HTLD-2024-4cWI-SPL-G2-STH/2024-4cWI-SPL-G2-STH-TeamB/README.md

# 2024-4cWI-SPL-G2-STH-TeamB
PV Module Frame Construction
