HTLD-2024-4cWI-SPL-G2-STH/2024-4cWI-SPL-G2-STH-TeamB/CAD_Design_Final.step

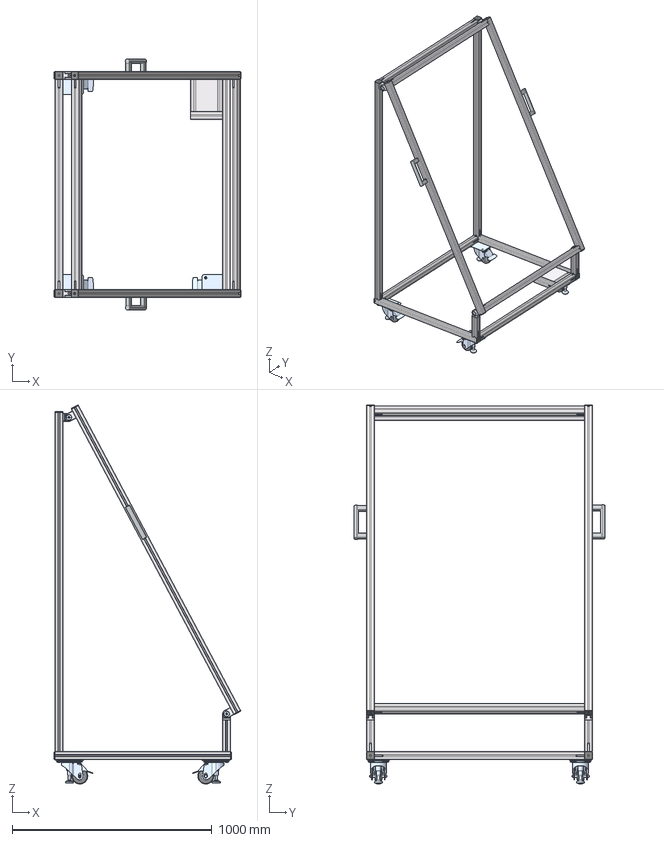
[picture p1: CAD file, 2025-06-10]
CAD_Design_Final.step
934.9 x 1258.7 x 1899.0 mm
item_0064764_Zylinderschraube DIN 912 M8x16_3
item_0064764_Zylinderschraube DIN 912 M8x16_2
item_0048048_Nutenstein V 8 St M8_7
item_0048048_Nutenstein V 8 St M8_5
item_0049486_Handgriff X 160 PA_3
item_0064764_Zylinderschraube DIN 912 M8x16_1
item_0064764_Zylinderschraube DIN 912 M8x16
item_0048048_Nutenstein V 8 St M8_3
item_0048048_Nutenstein V 8 St M8_1
item_0049486_Handgriff X 160 PA_1
item_0061631_Automatik-Verbindungssatz 8 Abdeckblende_65
item_0038808_Automatik-Verbindungssatz 8_65
item_0061631_Automatik-Verbindungssatz 8 Abdeckblende_63
item_0038808_Automatik-Verbindungssatz 8_63
item_0002618_Nutenstein 8 St M8_11
item_0049411_Schwenklager 8 40x40_W=62_11
item_0049411_Schwenklager 8 40x40_W=62_10
item_0049411_Schwenklager 8 40x40_W=62_9
item_0049411_Schwenklager 8 40x40_W=62_8
item_0002618_Nutenstein 8 St M8_9
item_0049411_Schwenklager 8 40x40_W=62_5
item_0049411_Schwenklager 8 40x40_W=62_4
item_0049411_Schwenklager 8 40x40_W=62_3
item_0049411_Schwenklager 8 40x40_W=62_2
item_0062690_Abdeckkappe 8 40x40, gummiert_9
item_0062690_Abdeckkappe 8 40x40, gummiert_8
item_0062690_Abdeckkappe 8 40x40, gummiert_7
item_0062690_Abdeckkappe 8 40x40, gummiert_6
item_0002618_Nutenstein 8 St M8_7
item_0002618_Nutenstein 8 St M8_5
item_0049411_Schwenklager 8 40x40_W=-28_11
item_0049411_Schwenklager 8 40x40_W=-28_10
item_0049411_Schwenklager 8 40x40_W=-28_9
item_0049411_Schwenklager 8 40x40_W=-28_8
item_0061631_Automatik-Verbindungssatz 8 Abdeckblende_61
item_0038808_Automatik-Verbindungssatz 8_61
item_0061631_Automatik-Verbindungssatz 8 Abdeckblende_59
item_0038808_Automatik-Verbindungssatz 8_59
item_0061631_Automatik-Verbindungssatz 8 Abdeckblende_57
item_0038808_Automatik-Verbindungssatz 8_57
item_0061631_Automatik-Verbindungssatz 8 Abdeckblende_55
item_0038808_Automatik-Verbindungssatz 8_55
item_0061631_Automatik-Verbindungssatz 8 Abdeckblende_53
item_0038808_Automatik-Verbindungssatz 8_53
item_0061631_Automatik-Verbindungssatz 8 Abdeckblende_51
item_0038808_Automatik-Verbindungssatz 8_51
item_0061631_Automatik-Verbindungssatz 8 Abdeckblende_49
item_0038808_Automatik-Verbindungssatz 8_49
item_0061631_Automatik-Verbindungssatz 8 Abdeckblende_47
item_0038808_Automatik-Verbindungssatz 8_47
item_0002603_Profil 8 40x40_L=1052.5_4
item_0002603_Profil 8 40x40_L=1052.5_3
item_0002603_Profil 8 40x40_L=1730_1
item_0002603_Profil 8 40x40_L=1730
item_0002618_Nutenstein 8 St M8_3
item_0002618_Nutenstein 8 St M8_1
item_0049411_Schwenklager 8 40x40_W=-28_5
item_0049411_Schwenklager 8 40x40_W=-28_4
item_0049411_Schwenklager 8 40x40_W=-28_3
item_0049411_Schwenklager 8 40x40_W=-28_2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
