HTLD-2024-4cWI-SPL-G2-STH/2024-4cWI-SPL-G2-STH-TeamB/(threads)

Thread 8 (2024-11-12):

Initial planning and Measuring

Raphael-Maringer, 2024-11-12:
As a team of developers, we want to measure the dimensions of the PV panel and discuss how we will implement the key functionalities (e.g. adjustable incline, mobility) so that we can design a frame that meets all requirements.

Acceptance Criteria:

- Correct measurements of the PV panel
- Key functionalities identified and written down

Closed 2024-11-12.

Thread 12 (2024-11-26):

Adjustable Panel Mount

scalarion, 2024-11-26:
As a user I want to be able to adjust the angle of the PV panel so that I can optimize energy production.

Acceptance Criteria:
- Panel angle adjustment mechanism allows setting between 0-45°
- Panel produces >95% of max rated power when set to 30° angle at solar noon
- Adjustment can be completed in <2 minutes without special tools
- Locking mechanism withstands 750N vertical load test for 24h without movement
- Frame stability test: <1cm deviation from vertical when pushed with 300N horizontal force at max height
- All tests and protocols documented in the project Wiki

Thread 13 (2024-11-26):

Mobile Frame with Coasters

scalarion, 2024-11-26:
As a user I want the frame to have coasters so that I can move it around freely.

Acceptance Criteria:
- Frame equipped with 4x industrial-grade 360° coasters rated for min. 25kg each
- Each coaster has individual braking mechanism that holds against 200N horizontal force
- Frame maintains vertical position within ±2° when moved on flat surface
- Maximum rolling resistance of 150N force required to initiate movement
- Coasters rated IP65 for water/dust protection
- Frame stability test: <1cm deviation from vertical when pushed with 300N horizontal force at max height
- All tests and protocols documented in the project Wiki
