HTLD-2024-4cWI-SPL-G2-STH/2024-4cWI-SPL-G2-STH-TeamB/Frame_full-documentation.pdf

## Projektübersicht

### Projektname: Neuer PV Modul Rahmen, fertig

### Projektnummer: 0f5f4bc1ac574d02a5001c80fd883be35

### Projektbeschreibung: endlich, der schmerz

i24.ws/6Jj3yt1W

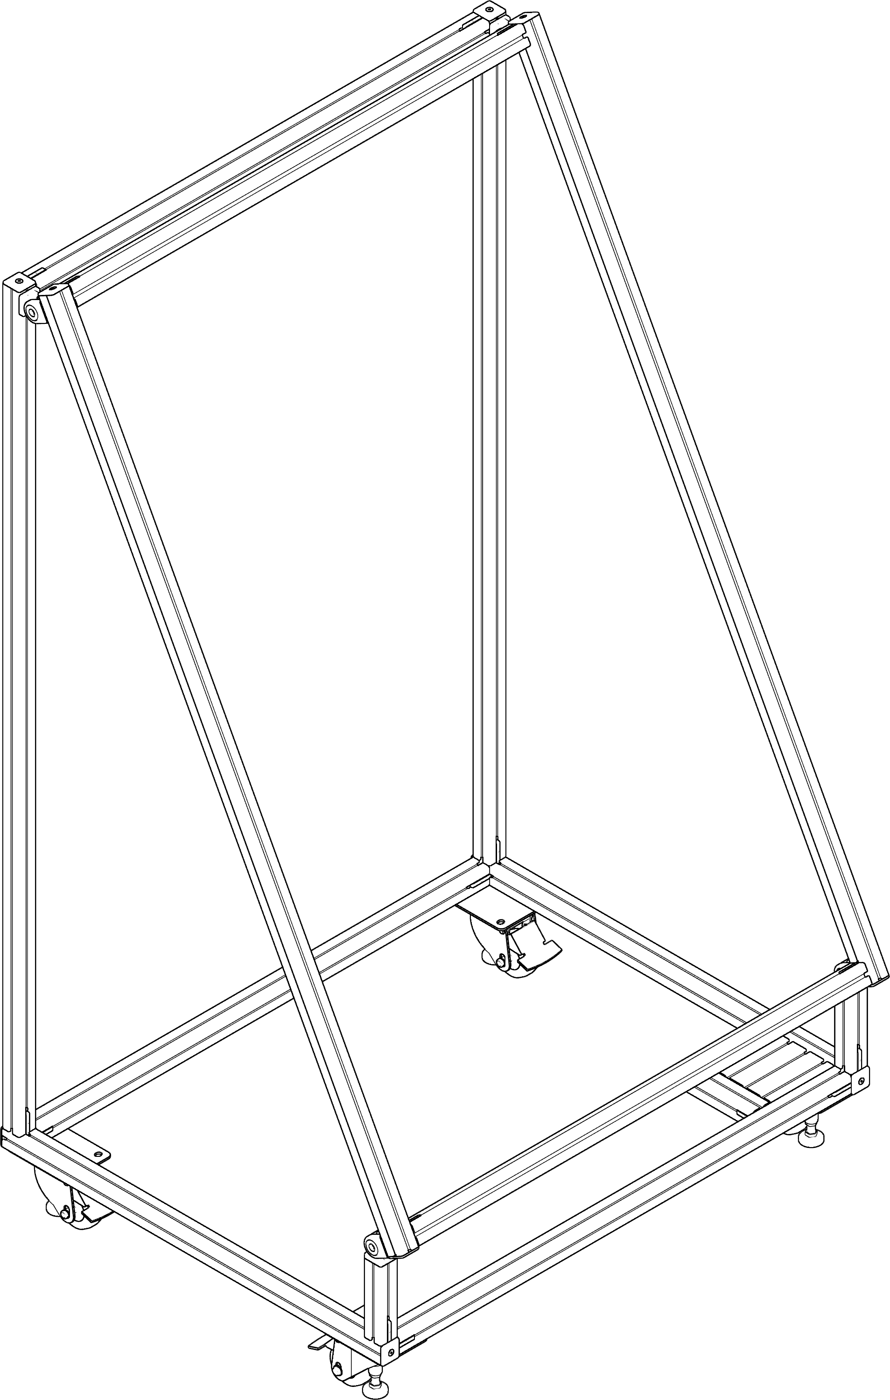
[picture p2: figure]

Seite 1 / 15 Projekt: Neuer PV Modul Rahmen, fertig, 0f5f4bc1ac574d02a5001c80fd883be35

# Baugruppenübersicht

## Projektübersicht | Baugruppenübersicht | Lieferstückliste | Stückliste | Unbearbeitete Profile | Profilbearbeitungen |

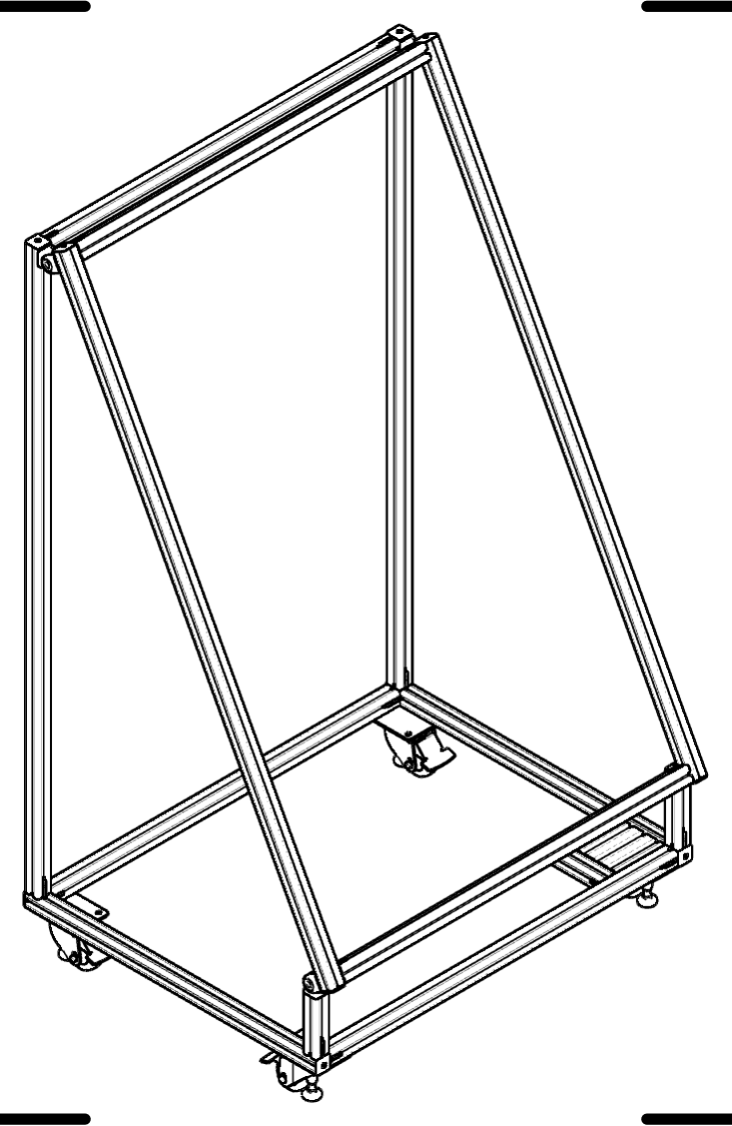
[picture p3: figure]

## Baugruppe 1

## Isometrische Ansicht | Dreitafelprojektion | Explosionsdarstellung | Montageanleitung |

Seite 2 / 15 Projekt: Neuer PV Modul Rahmen, fertig, 0f5f4bc1ac574d02a5001c80fd883be35

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
## Lieferstückliste

Anzahl | Artikelbezeichnung | Artikel-Nr. | Position
1 | Profil 8 40x40 leicht, natur Länge: 160mm | 0.0.026.33 | 1
2 | Profil 8 40x40 leicht, natur Länge: 880mm | 0.0.026.33 | 2
5 | Profil 8 40x40 leicht, natur Länge: 1052.5mm | 0.0.026.33 | 3
1 | Profil 8 40x40 leicht, natur Länge: 1700mm | 0.0.026.33 | 4
2 | Profil 8 40x40 leicht, natur Länge: 1730mm | 0.0.026.33 | 5
1 | Profil 8 160x40 leicht, natur Länge: 147mm | 0.0.418.35 | 6
1 | Profil 8 40x40 E, natur Länge: 1700mm | 7.0.000.09 | 7
2 | Profil 8 40x40 leicht, natur Länge: 159.23mm | 0.0.026.33 | 8v
33 | Automatik-Verbindungssatz 8 Abdeckblende, grau ähnlich RAL 7042 | 0.0.616.31 | 9
10 | Abdeckkappe 8 40x40, gummiert | 0.0.626.90 | 10
4 | Heberolle D80 140x110 mit Fußpedal ESD | 0.0.684.37 | 11
5 | Nutenstein 8 St M8, verzinkt | 0.0.026.18 | 12
33 | Automatik-Verbindungssatz 8, verzinkt | 0.0.388.08 | 13
4 | Schwenklager 8 40x40 | 0.0.494.11 | 14
12 | Befestigungssatz 8 für Lenk-/Bockrolle 140x110 | 0.0.670.18 | 15

Seite 3 / 15 Projekt: Neuer PV Modul Rahmen, fertig, 0f5f4bc1ac574d02a5001c80fd883be35

## Stückliste

Position | Artikelbezeichnung | Artikel-Nr. | Seite | Anzahl
1 | Profil 8 40x40 leicht, natur, Länge: 160mm | 0.0.026.33 | 5 | 1
2 | Profil 8 40x40 leicht, natur, Länge: 880mm | 0.0.026.33 | 5 | 2
3 | Profil 8 40x40 leicht, natur, Länge: 1052.5mm | 0.0.026.33 | 5 | 5
4 | Profil 8 40x40 leicht, natur, Länge: 1700mm | 0.0.026.33 | 5 | 1
5 | Profil 8 40x40 leicht, natur, Länge: 1730mm | 0.0.026.33 | 5 | 2
6 | Profil 8 160x40 leicht, natur, Länge: 147mm | 0.0.418.35 | 5 | 1
7 | Profil 8 40x40 E, natur, Länge: 1700mm | 7.0.000.09 | 6 | 1
8v | Profil 8 40x40 leicht, natur, Länge: 159.23mm | 0.0.026.33 | 7 | 2
9 | Automatik-Verbindungssatz 8 Abdeckblende, grau ähnlich RAL 7042 | 0.0.616.31 | - | 33
10 | Abdeckkappe 8 40x40, gummiert | 0.0.626.90 | - | 10
11 | Heberolle D80 140x110 mit Fußpedal ESD | 0.0.684.37 | - | 4
12 | Nutenstein 8 St M8, verzinkt | 0.0.026.18 | - | 5
13 | Automatik-Verbindungssatz 8, verzinkt | 0.0.388.08 | - | 33
14 | Schwenklager 8 40x40 | 0.0.494.11 | - | 4
15 | Befestigungssatz 8 für Lenk-/Bockrolle 140x110 | 0.0.670.18 | - | 12

## Verbindungstechnik ( gesamt )

5x

0.0.026.18

33x

0.0.388.08

4x

0.0.494.11

12x

0.0.670.18

Seite 4 / 15 Projekt: Neuer PV Modul Rahmen, fertig, 0f5f4bc1ac574d02a5001c80fd883be35

## Unbearbeitete Profile

## Teil 1, Profil 8 40x40 leicht, natur

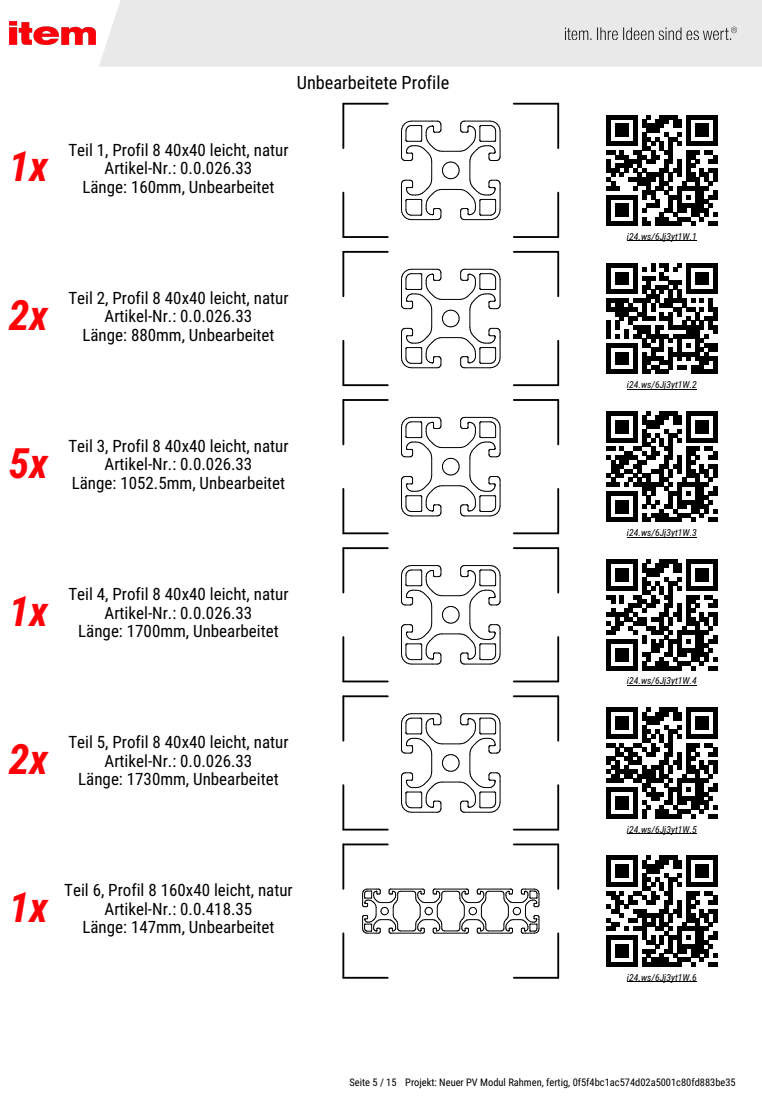
[picture p4: page 5]
Projekt : unnamed; Artikel-Nr.: 0.0.026.33; Länge: 160mm, Unbearbeitet 1x; Länge: 880mm, Unbearbeitet 2x; Länge: 1052.5mm, Unbearbeitet 5x; Länge: 1700mm, Unbearbeitet 1x; Länge: 1730mm, Unbearbeitet 2x; Artikel-Nr.: 0.0.418.35

Teil 2, Profil 8 40x40 leicht, natur
Artikel-Nr.: 0.0.026.33

Teil 3, Profil 8 40x40 leicht, natur

Teil 4, Profil 8 40x40 leicht, natur

Teil 5, Profil 8 40x40 leicht, natur

Teil 6, Profil 8 160x40 leicht, natur
Länge: 147mm, Unbearbeitet 1x

Seite 5 / 15 Projekt: Neuer PV Modul Rahmen, fertig, 0f5f4bc1ac574d02a5001c80fd883be35

## Unbearbeitete Profile

## Teil 7, Profil 8 40x40 E, natur

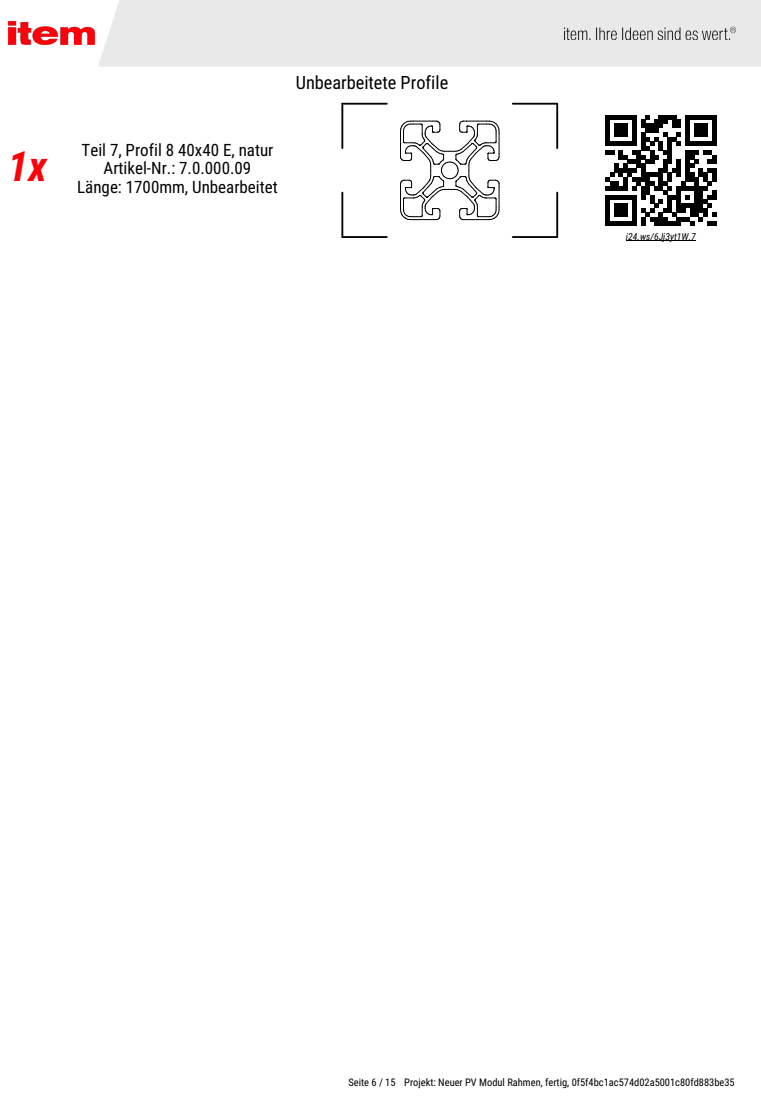
[picture p5: page 6]
Artikel-Nr.: 7.0.000.09; Länge: 1700mm, Unbearbeitet 1x

Seite 6 / 15 Projekt: Neuer PV Modul Rahmen, fertig, 0f5f4bc1ac574d02a5001c80fd883be35

Bearbeitungen Teil 8v, Profil 8 40x40 leicht, natur 2x | Artikel-Nr.: 0.0.026.33, Länge: 159.23mm

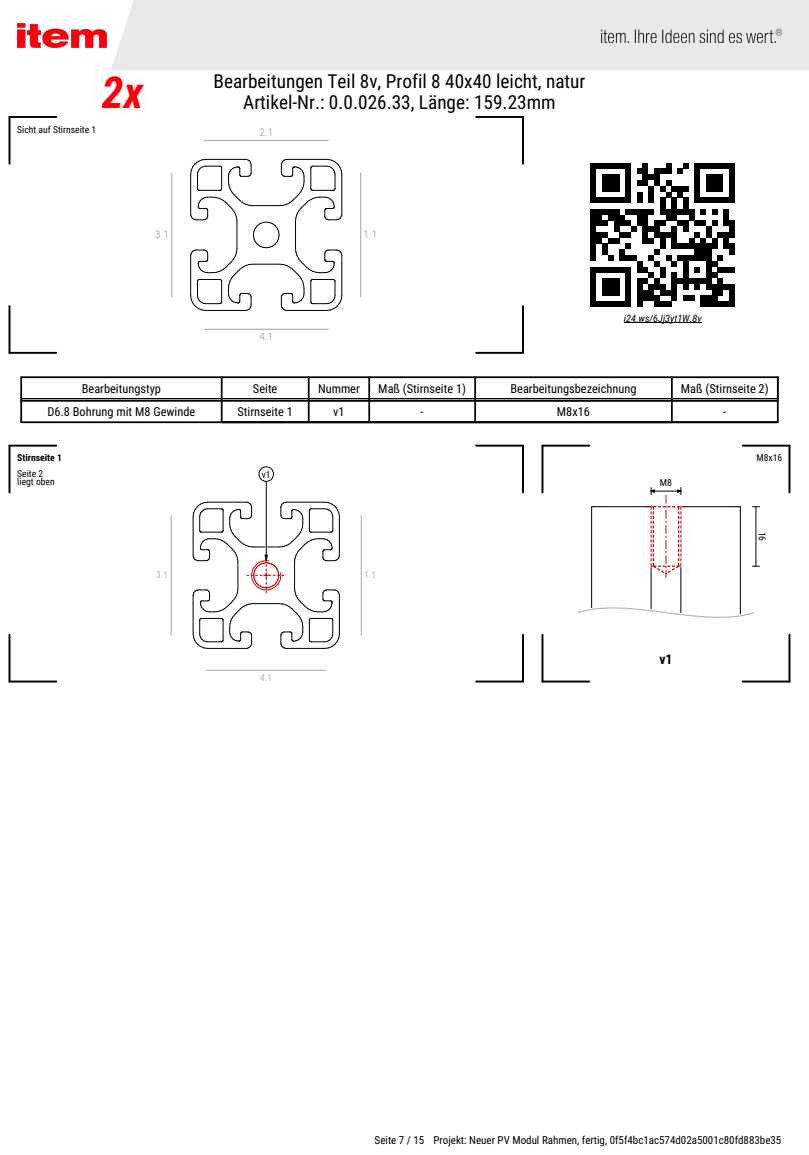
[picture p6: page 7]
Stirnseite 1; Seite 2; v1 liegt oben

Sicht auf Stirnseite 1

Bearbeitungstyp | Seite | Nummer | Maß (Stirnseite 1) | Bearbeitungsbezeichnung | Maß (Stirnseite 2)
D6.8 Bohrung mit M8 Gewinde | Stirnseite 1 | v1 | - | M8x16 | -

Seite 7 / 15 Projekt: Neuer PV Modul Rahmen, fertig, 0f5f4bc1ac574d02a5001c80fd883be35

## Kontrollansicht (Bearbeitungen) Teil 8v

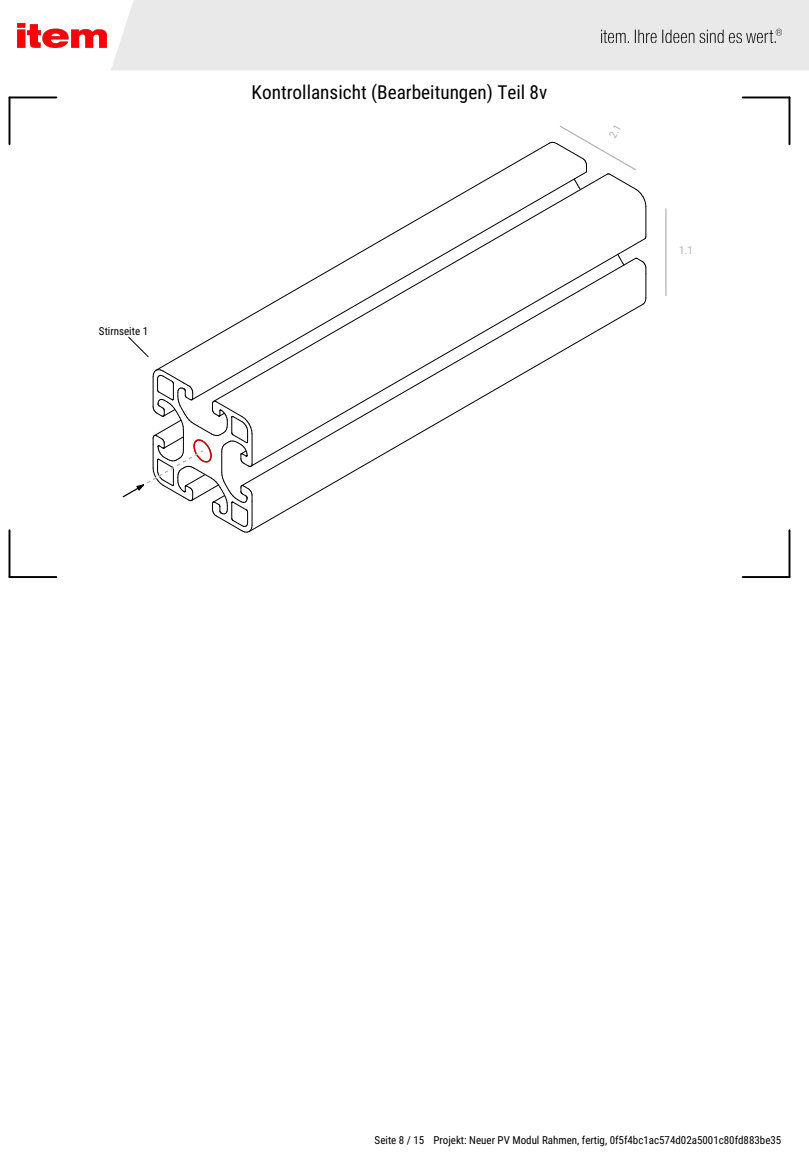
[picture p7: page 8]
Stirnseite 1

Seite 8 / 15 Projekt: Neuer PV Modul Rahmen, fertig, 0f5f4bc1ac574d02a5001c80fd883be35

## Isometrische Ansicht Baugruppe 1 / 1

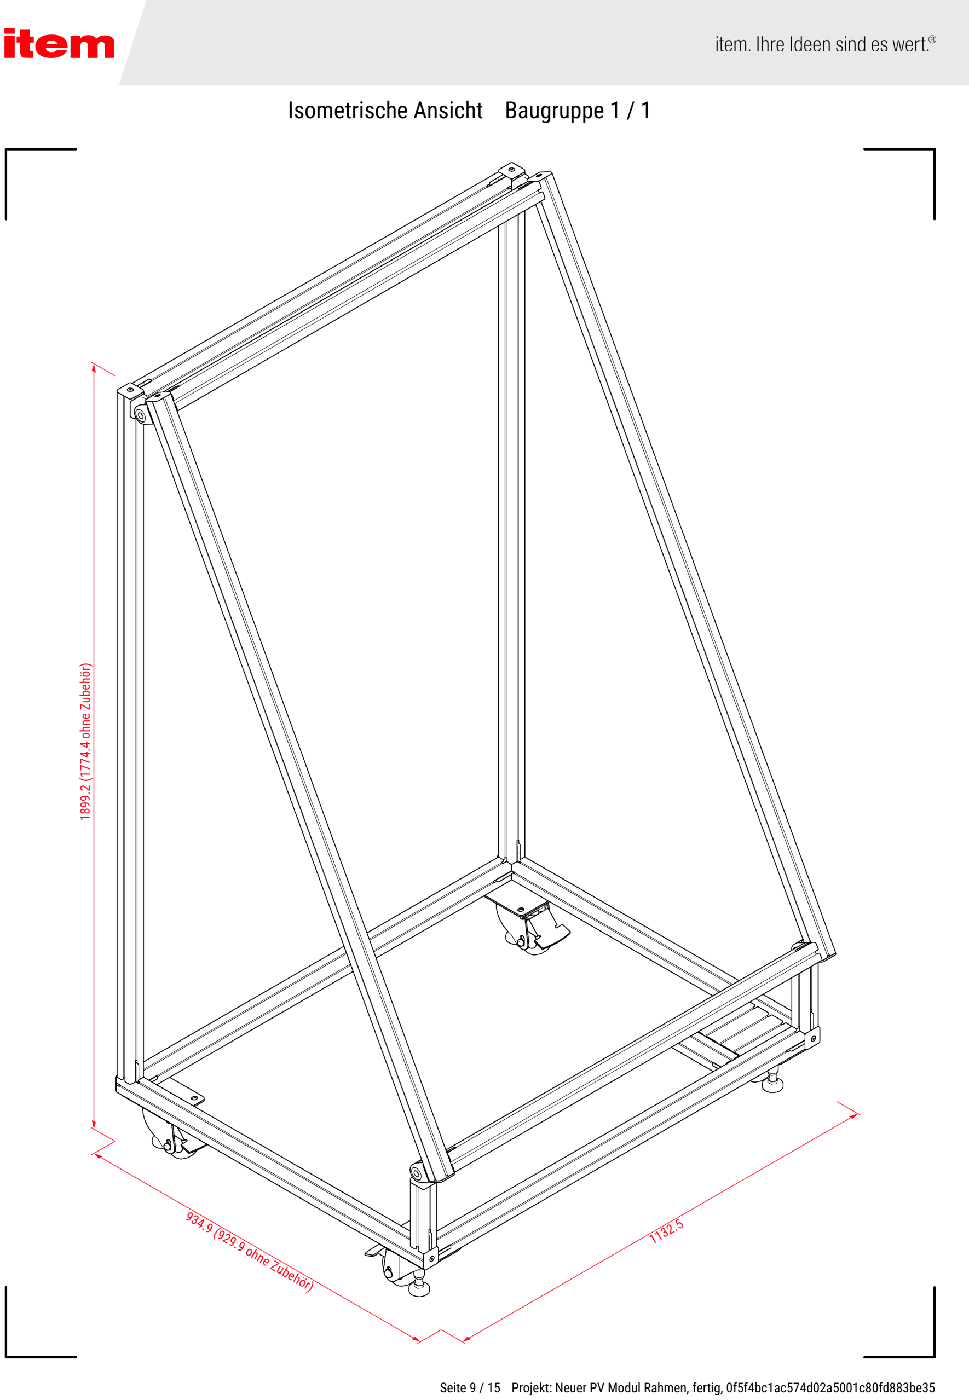
[picture p8: page 9]

Seite 9 / 15 Projekt: Neuer PV Modul Rahmen, fertig, 0f5f4bc1ac574d02a5001c80fd883be35

## Dreitafelprojektion Baugruppe 1 / 1

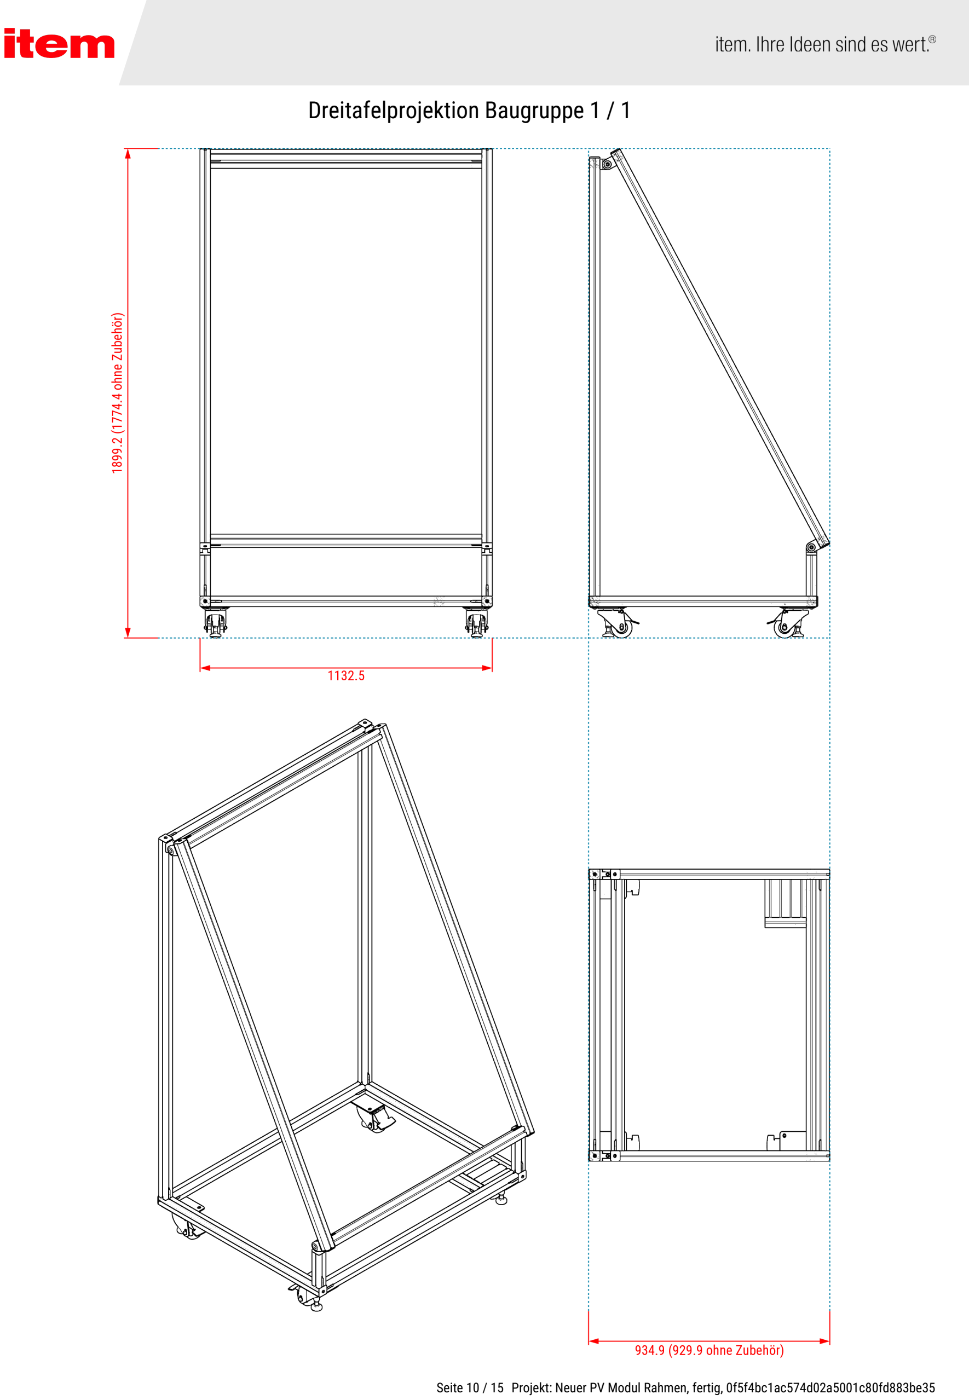
[picture p9: page 10]

Seite 10 / 15 Projekt: Neuer PV Modul Rahmen, fertig, 0f5f4bc1ac574d02a5001c80fd883be35

## Explosionsdarstellung Baugruppe 1 / 1

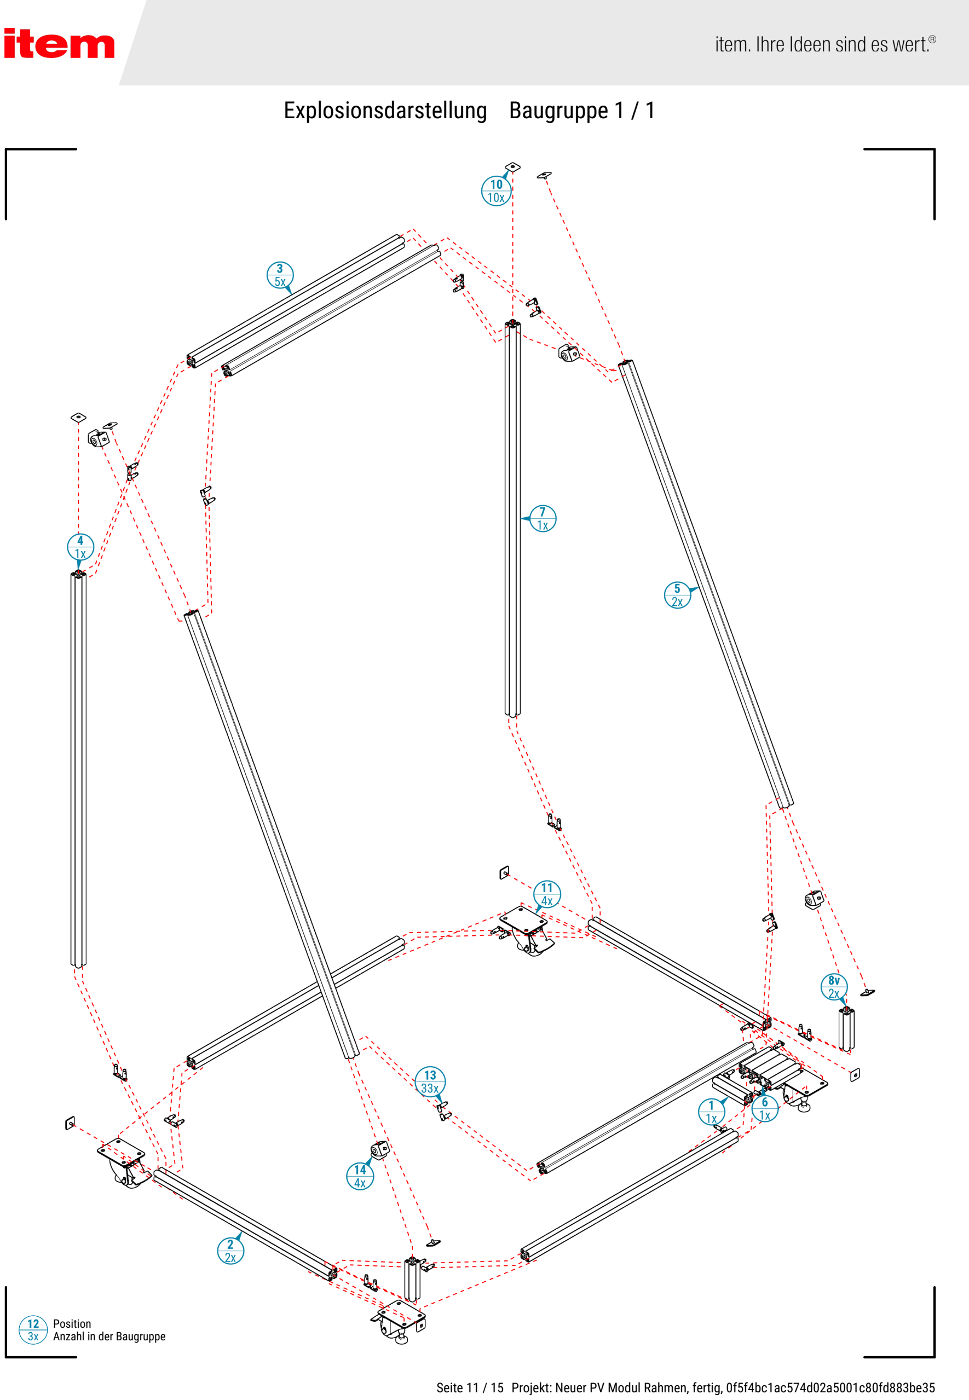
[picture p10: page 11]

### 12 Position

3x Anzahl in der Baugruppe

Seite 11 / 15 Projekt: Neuer PV Modul Rahmen, fertig, 0f5f4bc1ac574d02a5001c80fd883be35

## Montageanleitung

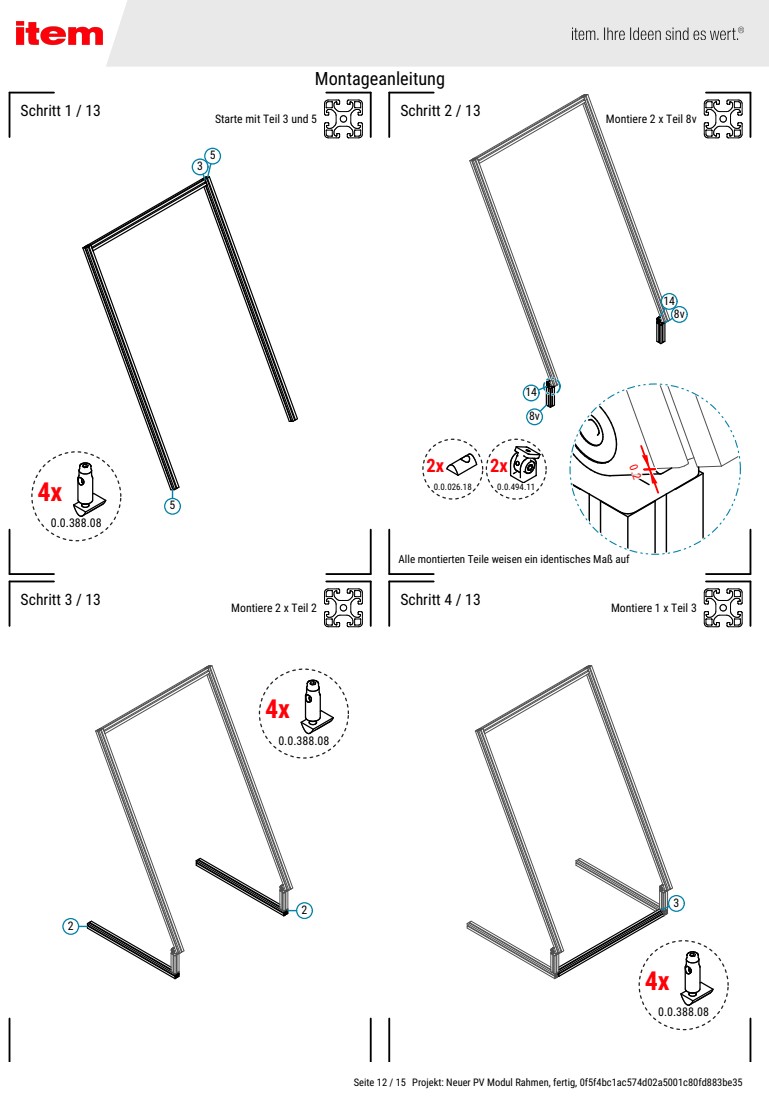
[picture p11: page 12]

Starte mit Teil 3 und 5 Schritt 1 / 13

Montiere 2 x Teil 8v Schritt 2 / 13

Alle montierten Teile weisen ein identisches Maß auf

Montiere 2 x Teil 2 Schritt 3 / 13

Montiere 1 x Teil 3 Schritt 4 / 13

Seite 12 / 15 Projekt: Neuer PV Modul Rahmen, fertig, 0f5f4bc1ac574d02a5001c80fd883be35

## Montageanleitung

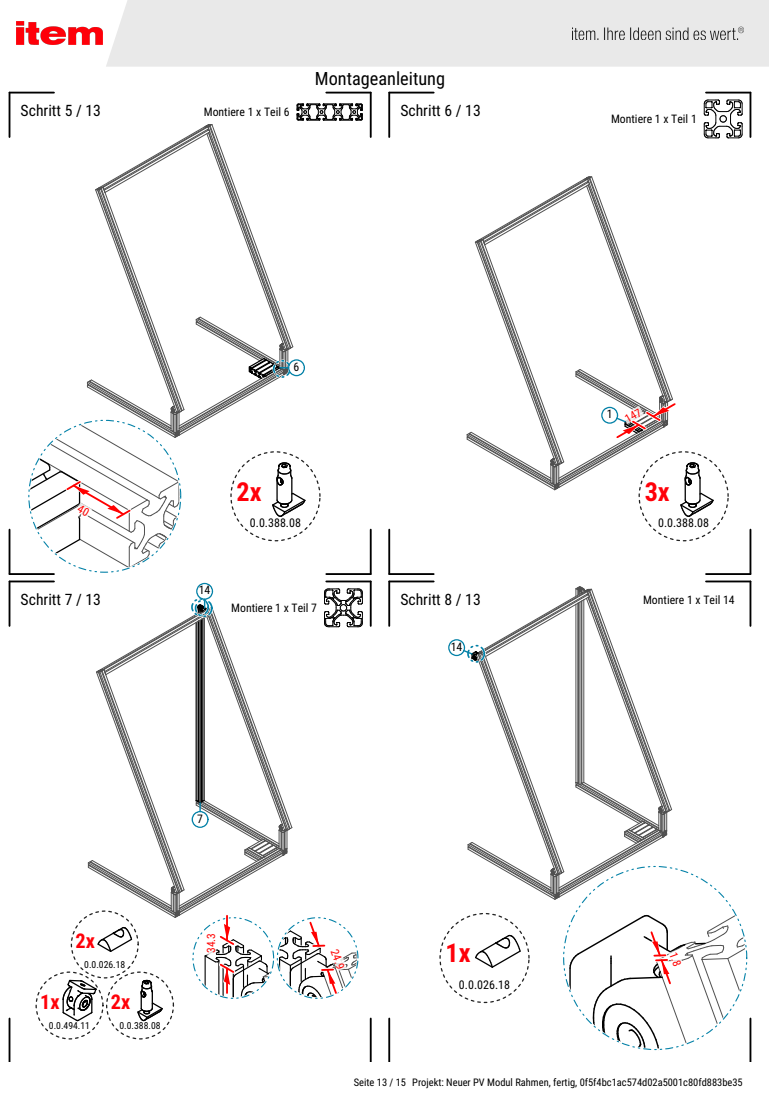
[picture p12: page 13]
Schritt 5 / 13; Montiere 1 x Teil 6; Schritt 8 / 13; Montiere 1 x Teil 14

Montiere 1 x Teil 1 Schritt 6 / 13

Montiere 1 x Teil 7 Schritt 7 / 13

Seite 13 / 15 Projekt: Neuer PV Modul Rahmen, fertig, 0f5f4bc1ac574d02a5001c80fd883be35

## Montageanleitung

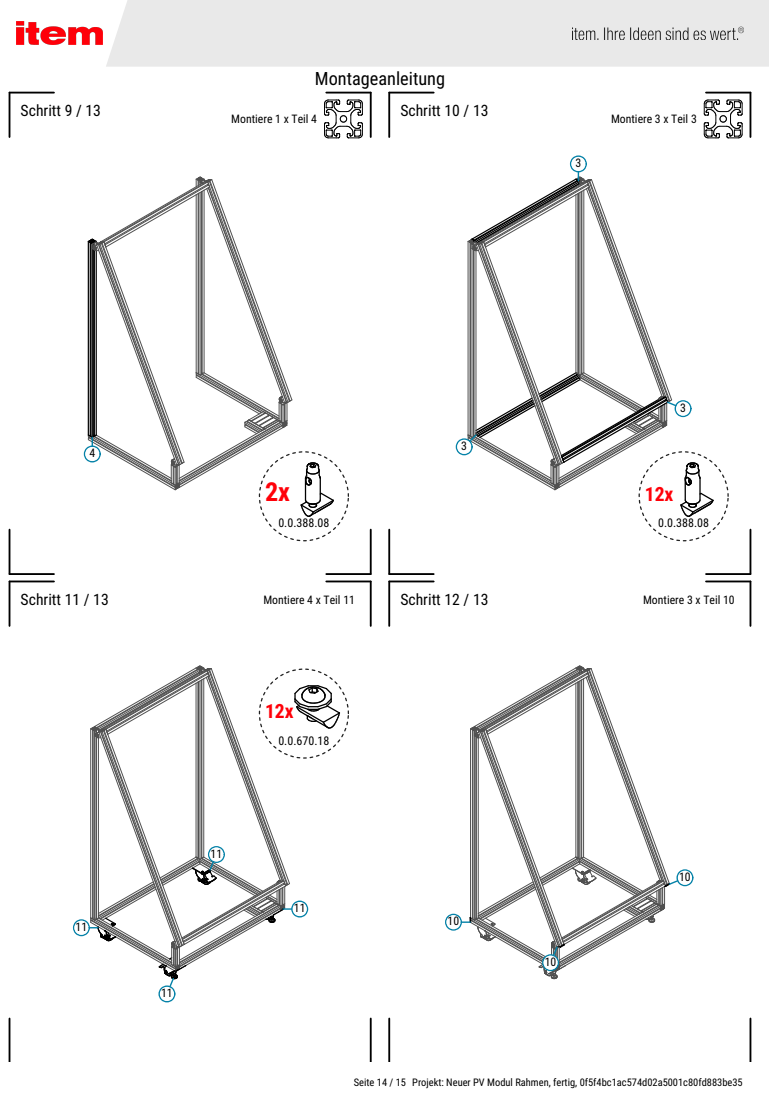
[picture p13: page 14]
Schritt 11 / 13; Montiere 4 x Teil 11; Schritt 12 / 13; Montiere 3 x Teil 10

Montiere 1 x Teil 4 Schritt 9 / 13

Montiere 3 x Teil 3 Schritt 10 / 13

Seite 14 / 15 Projekt: Neuer PV Modul Rahmen, fertig, 0f5f4bc1ac574d02a5001c80fd883be35

## Montageanleitung

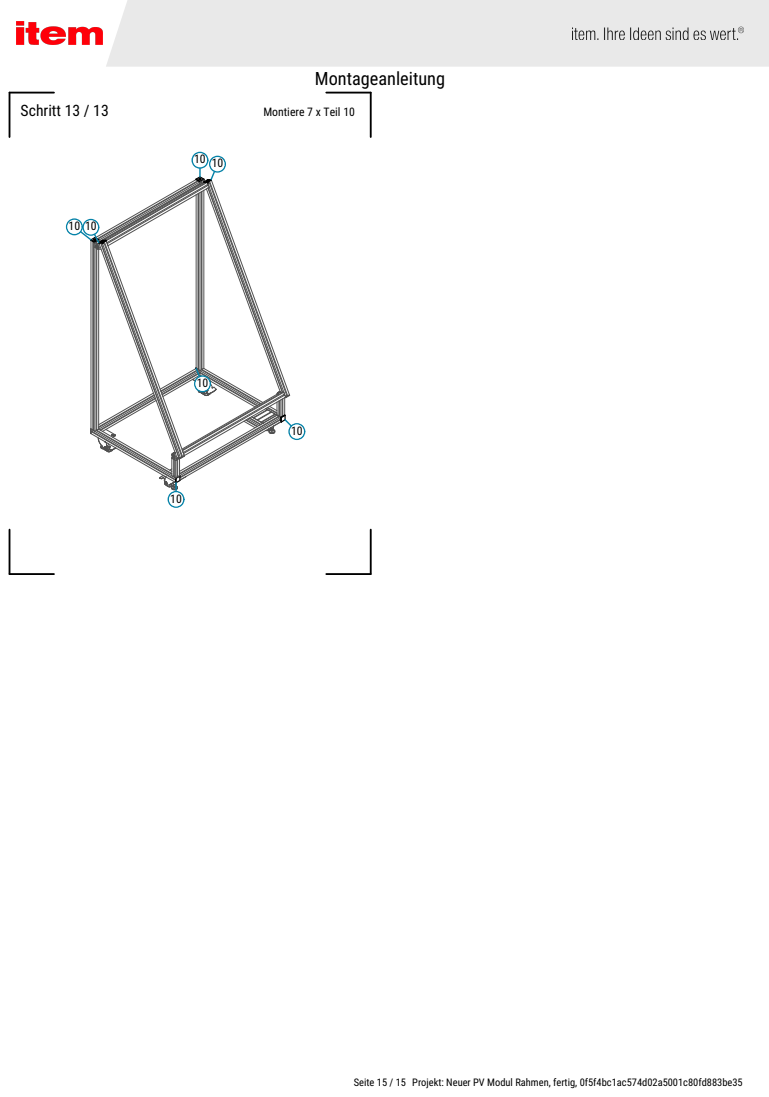
[picture p14: page 15]
Schritt 13 / 13; Montiere 7 x Teil 10

Seite 15 / 15 Projekt: Neuer PV Modul Rahmen, fertig, 0f5f4bc1ac574d02a5001c80fd883be35
