HTLD-2024-4cWI-SPL-G2-STH/2024-4cWI-SPL-G2-STH-TeamB/full_doc_en-AT_020fce40189548b49f6569aafb30beff14_abcdeimrstvxz.pdf

## Project overview

### Project name: N1 PV Halter

### Project number: 020fce40189548b49f6569aafb30beff14

### Project description: Nummer 1

i24.ws/nNwMweX7

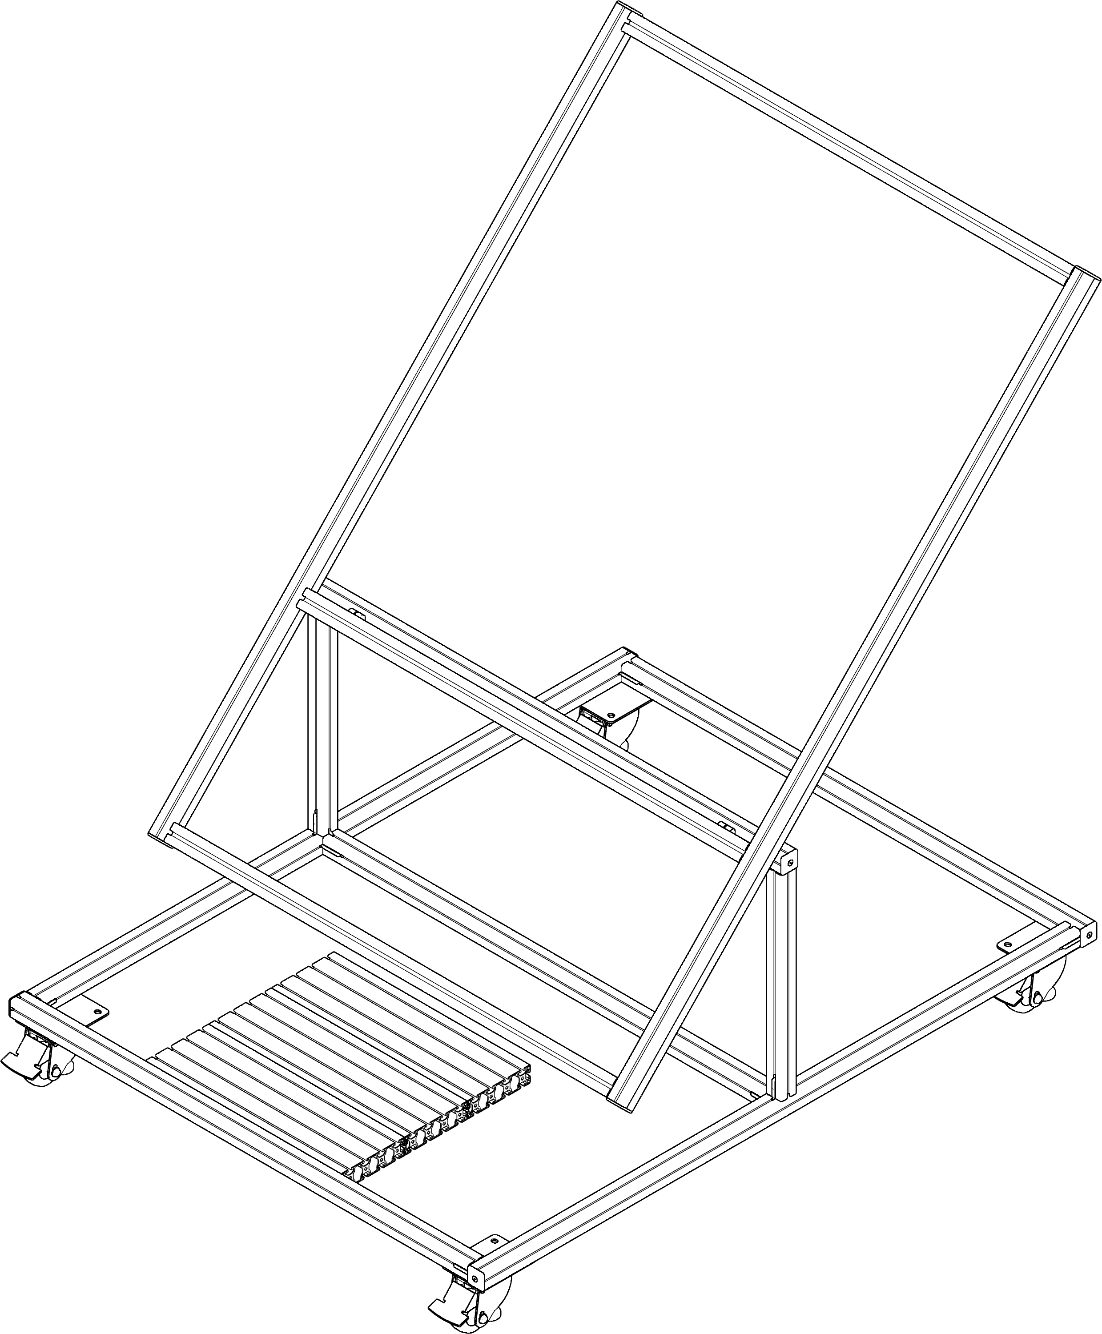
[picture p15: figure]

Page 1 / 12 | Project: N1 PV Halter, 020fce40189548b49f6569aafb30beff14

# Assembly overview

## Project overview | Assembly overview | Delivery list | Parts list | Unmachined profiles |

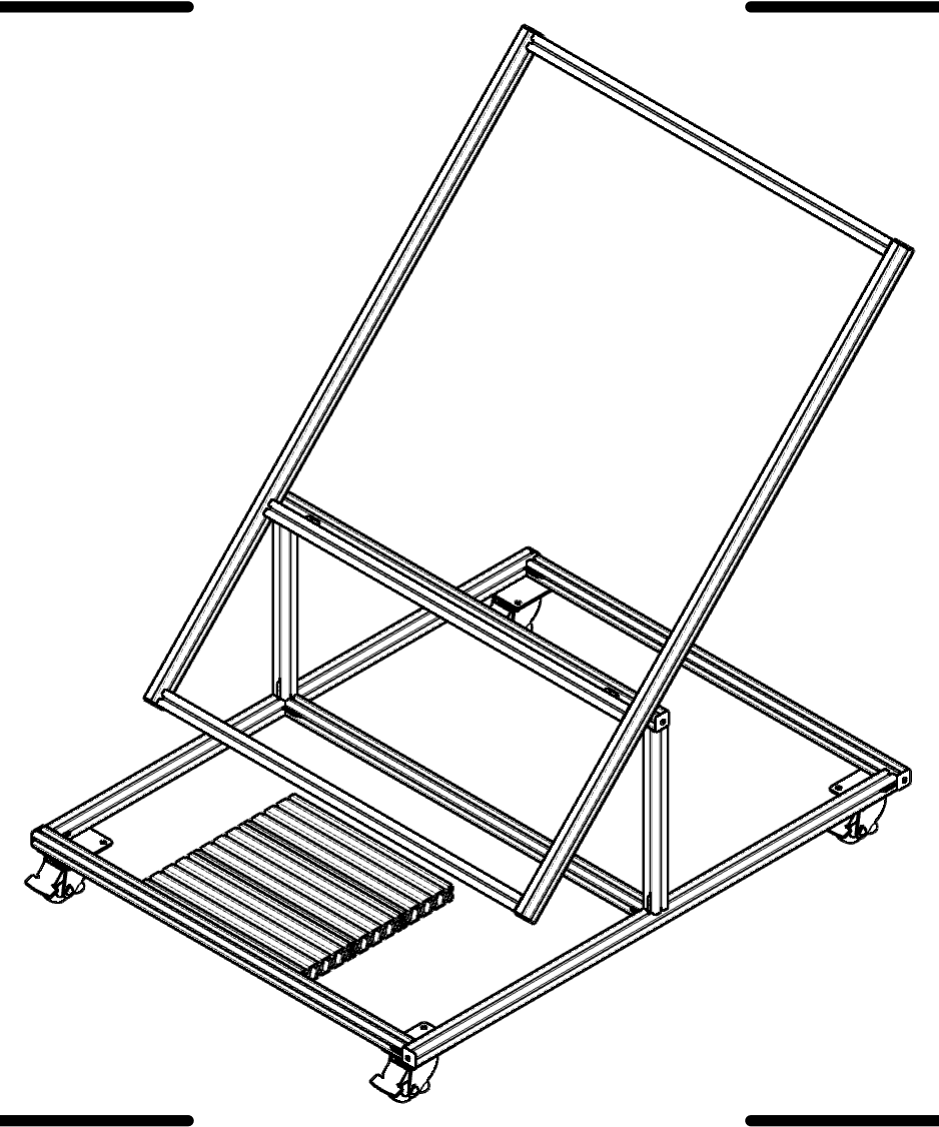
[picture p16: figure]

## Assembly 1

## Isometric view | Multiview projection | Exploded view | Assembly guide |

Page 2 / 12 | Project: N1 PV Halter, 020fce40189548b49f6569aafb30beff14

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
## Delivery list

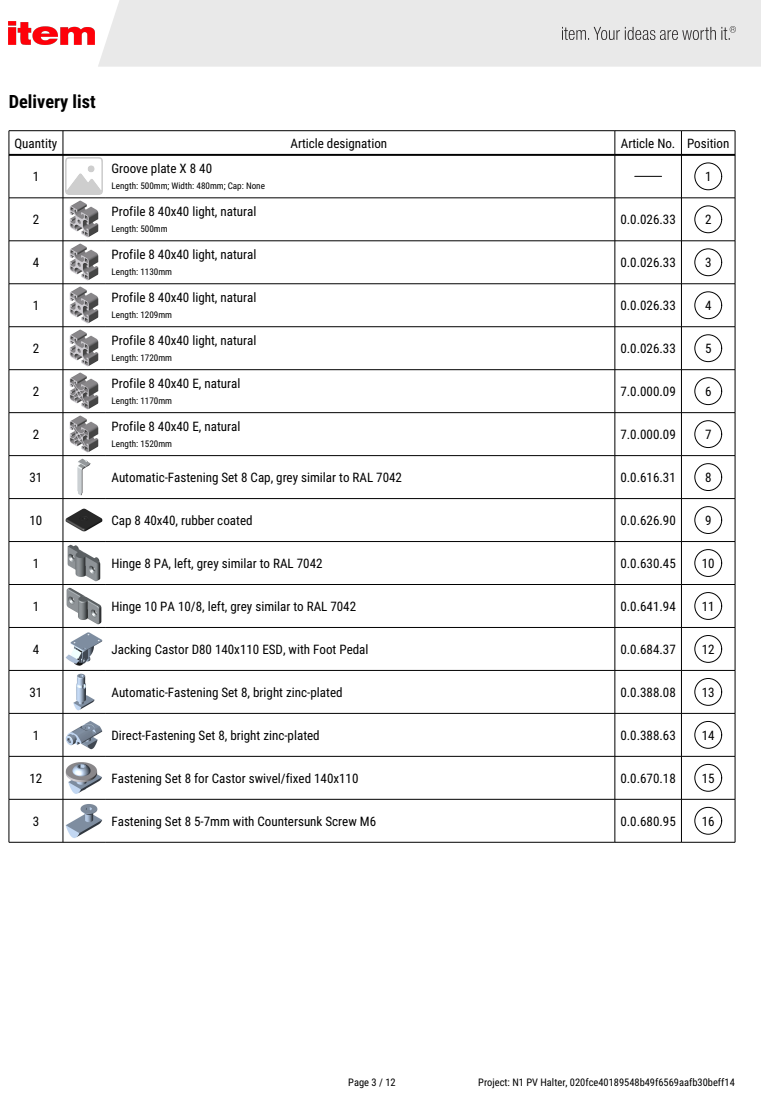
[picture p17: page 3]
Page 3 / 12; Project: N1 PV Halter, 020fce40189548b49f6569aafb30beff14

Quantity | Article designation | Article No. | Position

1 | Groove plate X 8 40 Length: 500mm; Width: 480mm; Cap: None | | 1

2 | Profile 8 40x40 light, natural Length: 500mm | 0.0.026.33 | 2

4 | Profile 8 40x40 light, natural Length: 1130mm | 0.0.026.33 | 3

1 | Profile 8 40x40 light, natural Length: 1209mm | 0.0.026.33 | 4

2 | Profile 8 40x40 light, natural Length: 1720mm | 0.0.026.33 | 5

2 | Profile 8 40x40 E, natural Length: 1170mm | 7.0.000.09 | 6

2 | Profile 8 40x40 E, natural Length: 1520mm | 7.0.000.09 | 7

31 | Automatic-Fastening Set 8 Cap, grey similar to RAL 7042 | 0.0.616.31 | 8

10 | Cap 8 40x40, rubber coated | 0.0.626.90 | 9

1 | Hinge 8 PA, left, grey similar to RAL 7042 | 0.0.630.45 | 10

1 | Hinge 10 PA 10/8, left, grey similar to RAL 7042 | 0.0.641.94 | 11

4 | Jacking Castor D80 140x110 ESD, with Foot Pedal | 0.0.684.37 | 12

31 | Automatic-Fastening Set 8, bright zinc-plated | 0.0.388.08 | 13

1 | Direct-Fastening Set 8, bright zinc-plated | 0.0.388.63 | 14

12 | Fastening Set 8 for Castor swivel/fixed 140x110 | 0.0.670.18 | 15

3 | Fastening Set 8 5-7mm with Countersunk Screw M6 | 0.0.680.95 | 16

## Parts list

Position | Article designation | Article No. | Page | Quantity
1 | Groove plate X 8 40, Dimension: 500x480mm | - | - | 1
2 | Profile 8 40x40 light, natural, Length: 500mm | 0.0.026.33 | 5 | 2
3 | Profile 8 40x40 light, natural, Length: 1130mm | 0.0.026.33 | 5 | 4
4 | Profile 8 40x40 light, natural, Length: 1209mm | 0.0.026.33 | 5 | 1
5 | Profile 8 40x40 light, natural, Length: 1720mm | 0.0.026.33 | 5 | 2
6 | Profile 8 40x40 E, natural, Length: 1170mm | 7.0.000.09 | 5 | 2
7 | Profile 8 40x40 E, natural, Length: 1520mm | 7.0.000.09 | 5 | 2
8 | Automatic-Fastening Set 8 Cap, grey similar to RAL 7042 | 0.0.616.31 | - | 31
9 | Cap 8 40x40, rubber coated | 0.0.626.90 | - | 10
10 | Hinge 8 PA, left, grey similar to RAL 7042 | 0.0.630.45 | - | 1
11 | Hinge 10 PA 10/8, left, grey similar to RAL 7042 | 0.0.641.94 | - | 1
12 | Jacking Castor D80 140x110 ESD, with Foot Pedal | 0.0.684.37 | - | 4
13 | Automatic-Fastening Set 8, bright zinc-plated | 0.0.388.08 | - | 31
14 | Direct-Fastening Set 8, bright zinc-plated | 0.0.388.63 | - | 1
15 | Fastening Set 8 for Castor swivel/fixed 140x110 | 0.0.670.18 | - | 12
16 | Fastening Set 8 5-7mm with Countersunk Screw M6 | 0.0.680.95 | - | 3

## Fasteners ( All together )

31x

0.0.388.08

1x

0.0.388.63

12x

0.0.670.18

3x

0.0.680.95

Page 4 / 12 | Project: N1 PV Halter, 020fce40189548b49f6569aafb30beff14

## Unmachined profiles

## Part 2, Profile 8 40x40 light, natural

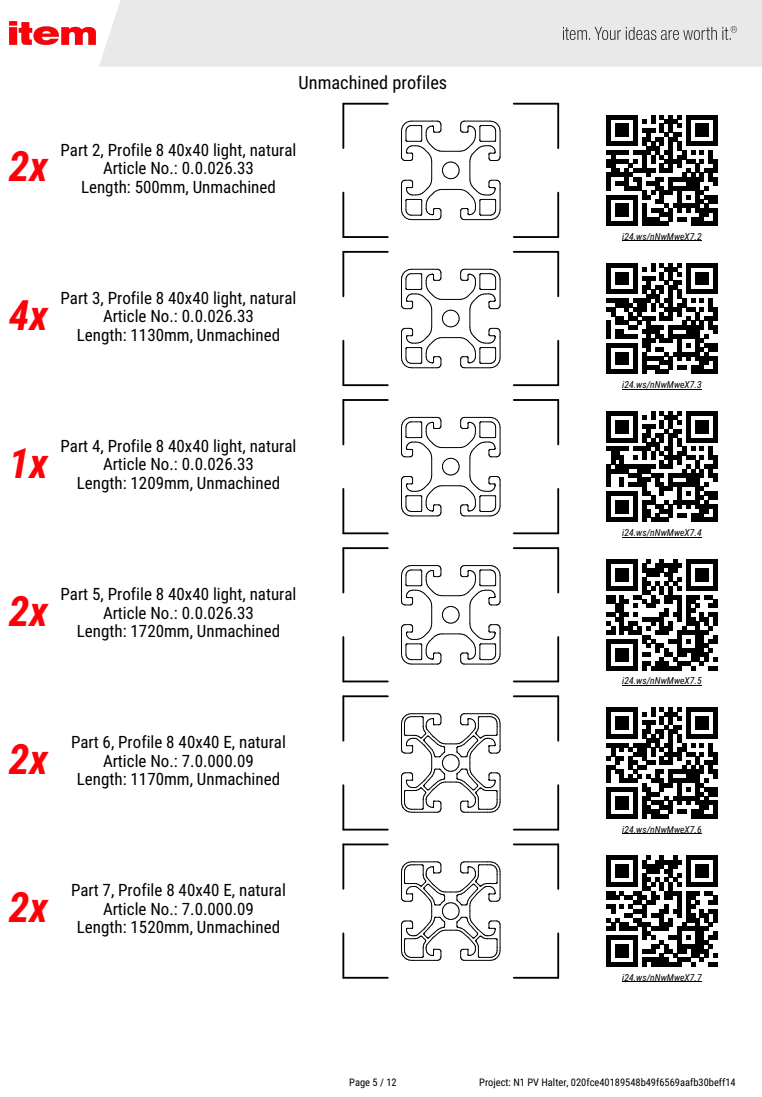
[picture p18: page 5]
Project : unnamed; Article No.: 0.0.026.33; Length: 500mm, Unmachined 2x; i24.ws/nNwMweX7.2; i24.ws/nNwMweX7.3; i24.ws/nNwMweX7.4; i24.ws/nNwMweX7.5; Length: 1170mm, Unmachined 2x; i24.ws/nNwMweX7.6; Length: 1520mm, Unmachined 2x; i24.ws/nNwMweX7.7; Page 5 / 12; Project: N1 PV Halter, 020fce40189548b49f6569aafb30beff14

Part 3, Profile 8 40x40 light, natural
Length: 1130mm, Unmachined 4x

Part 4, Profile 8 40x40 light, natural
Length: 1209mm, Unmachined 1x

Part 5, Profile 8 40x40 light, natural
Length: 1720mm, Unmachined 2x

Part 6, Profile 8 40x40 E, natural
Article No.: 7.0.000.09

Part 7, Profile 8 40x40 E, natural

## Isometric view Assembly 1 / 1

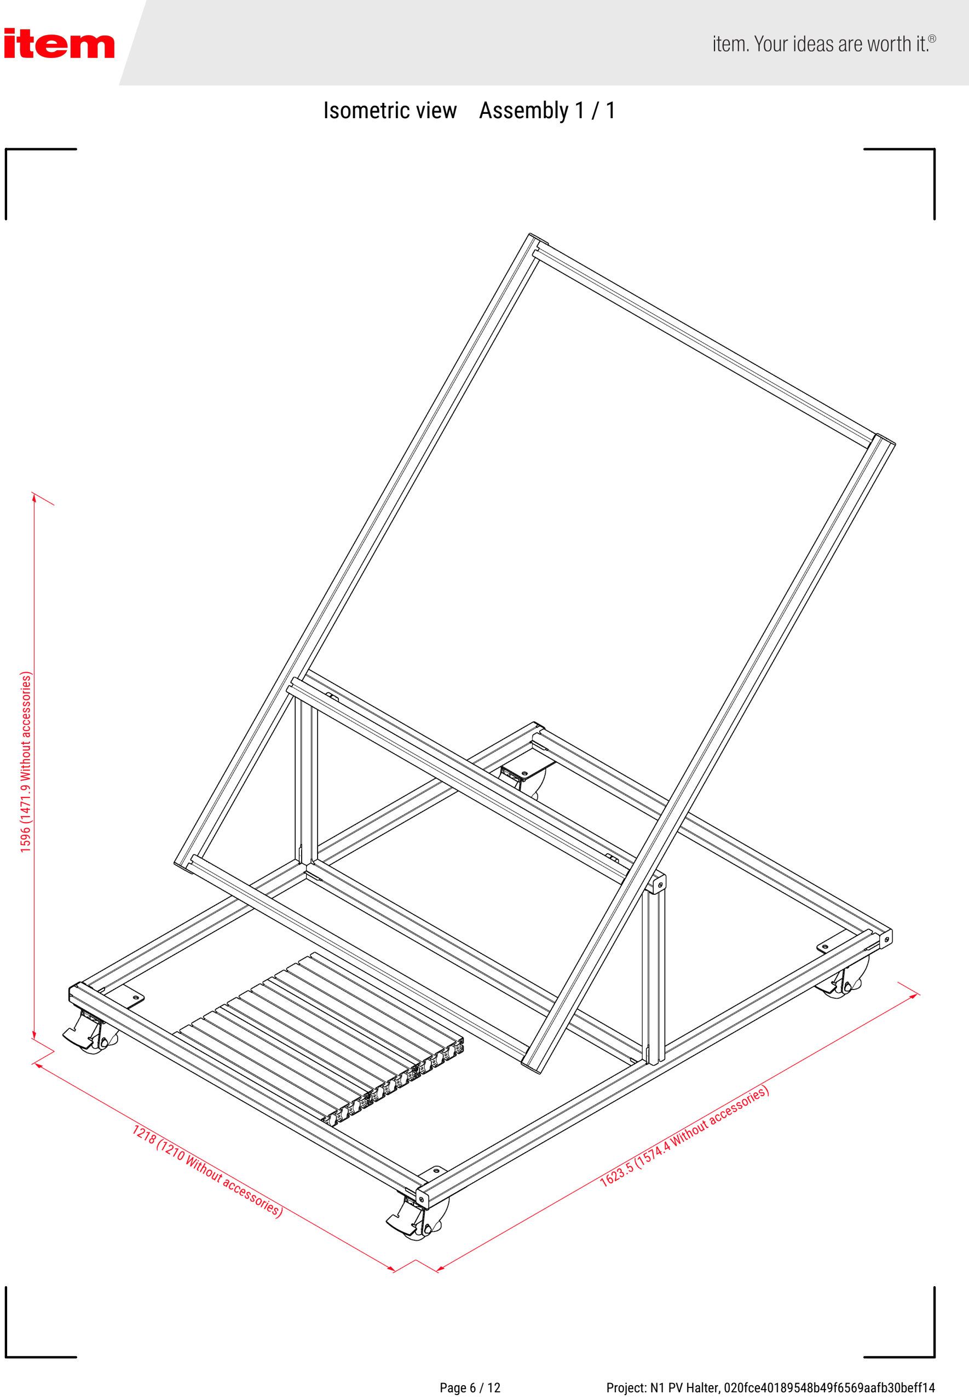
[picture p19: page 6]

Page 6 / 12 | Project: N1 PV Halter, 020fce40189548b49f6569aafb30beff14

## Multiview projection Assembly 1 / 1

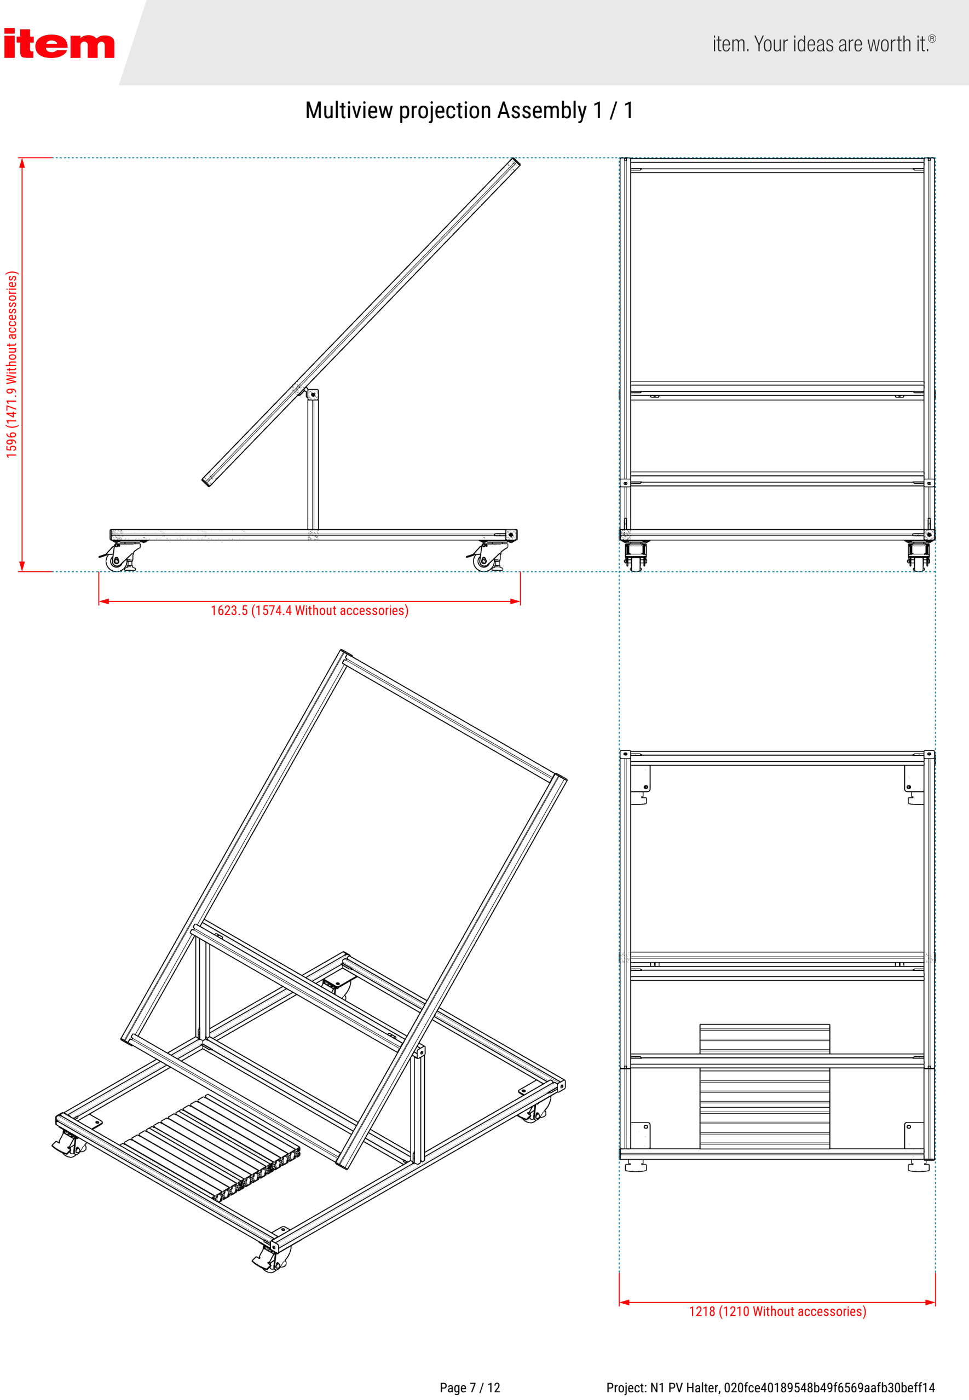
[picture p20: page 7]

Page 7 / 12 | Project: N1 PV Halter, 020fce40189548b49f6569aafb30beff14

## Exploded view Assembly 1 / 1

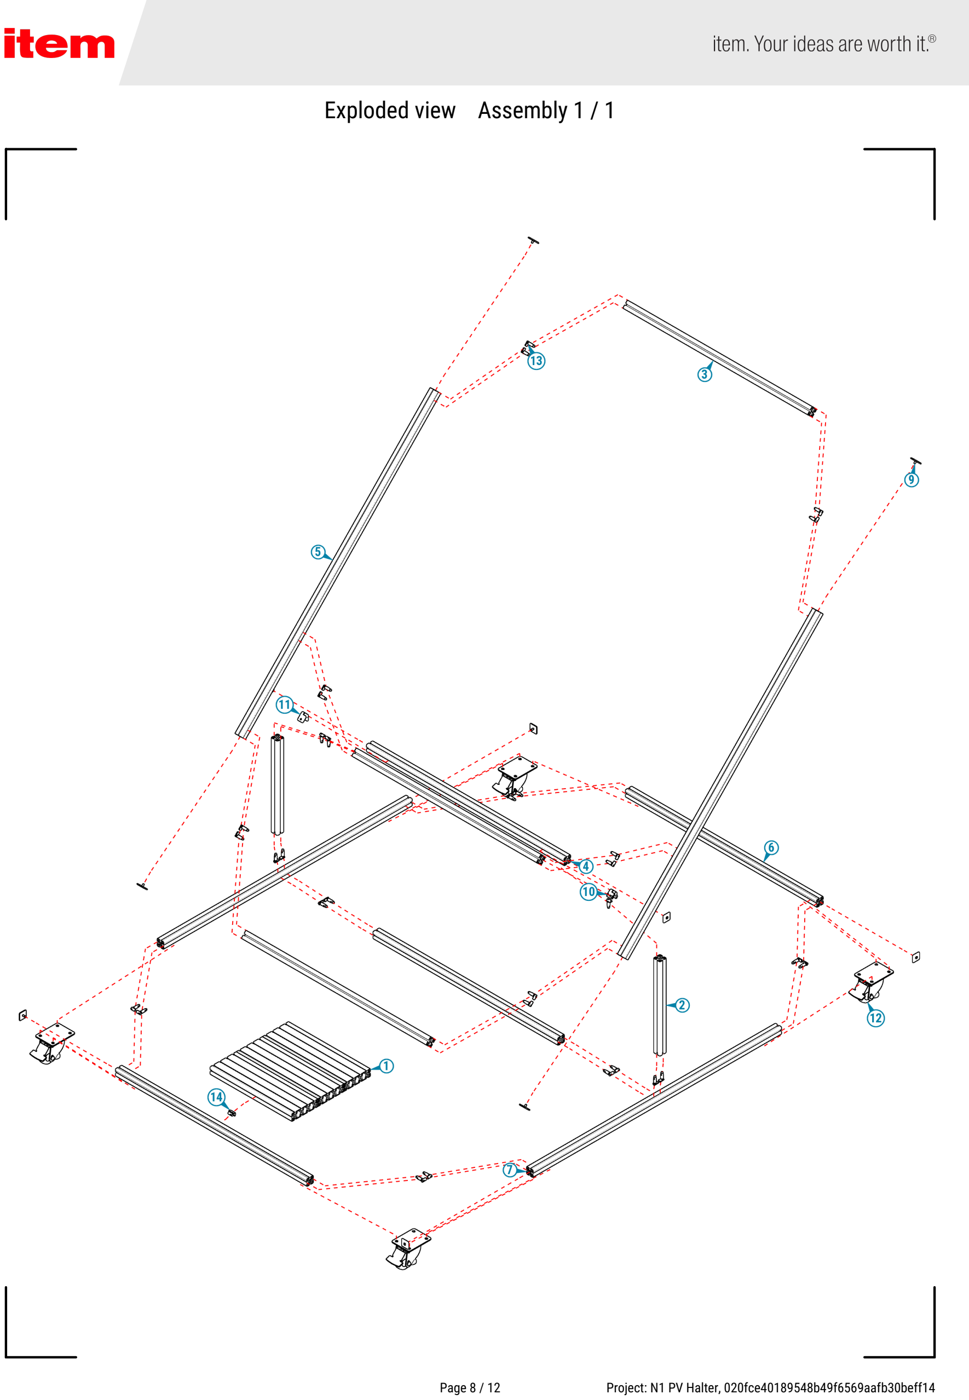
[picture p21: page 8]

Page 8 / 12 | Project: N1 PV Halter, 020fce40189548b49f6569aafb30beff14

## Assembly guide

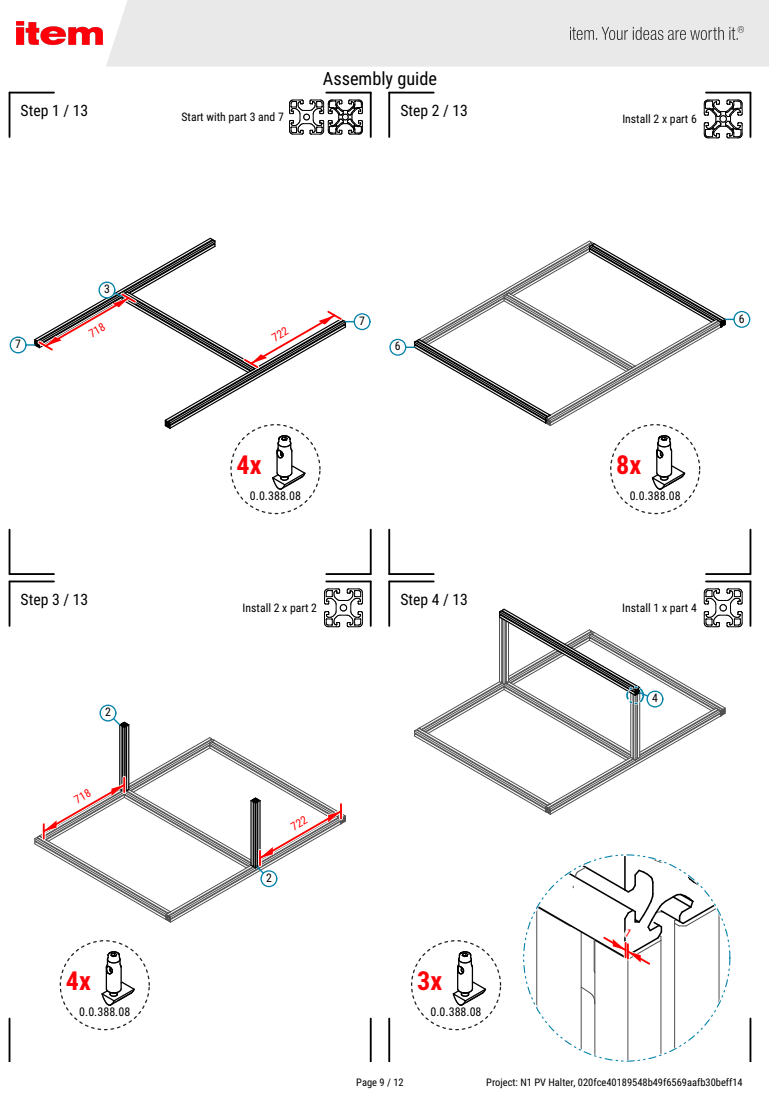
[picture p22: page 9]
Page 9 / 12; Project: N1 PV Halter, 020fce40189548b49f6569aafb30beff14

Start with part 3 and 7 Step 1 / 13

Install 2 x part 6 Step 2 / 13

Install 2 x part 2 Step 3 / 13

Install 1 x part 4 Step 4 / 13

## Assembly guide

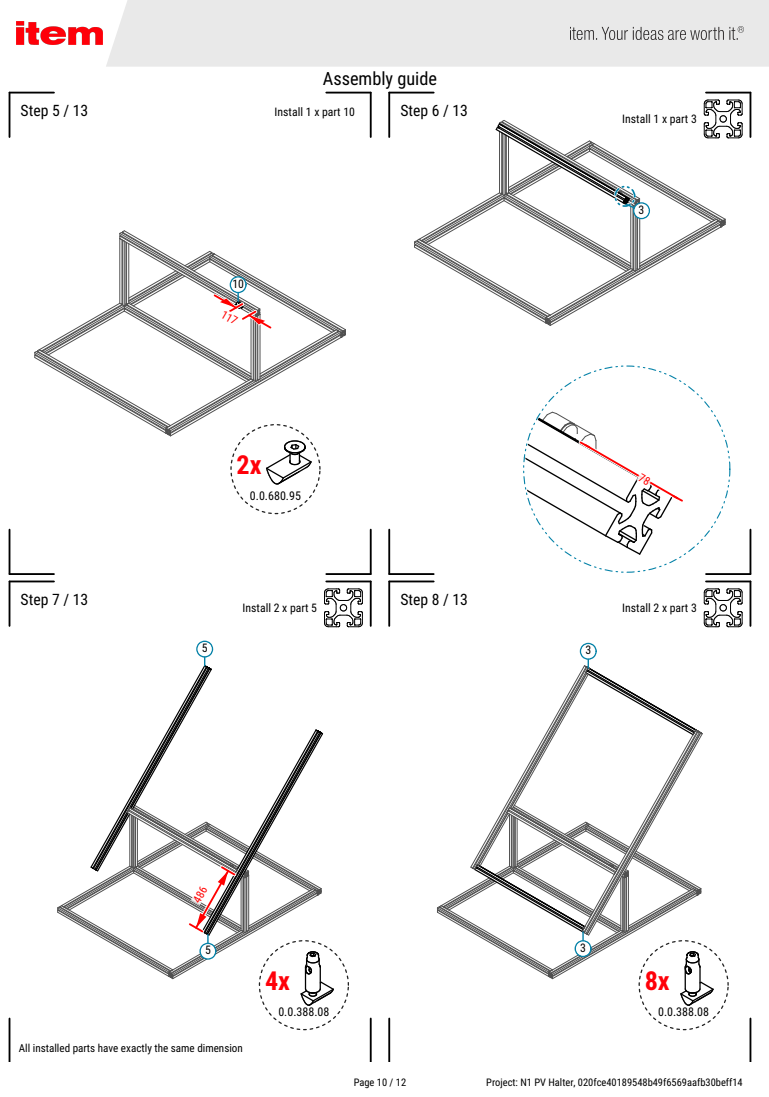
[picture p23: page 10]
Step 5 / 13; Install 1 x part 10; Page 10 / 12; Project: N1 PV Halter, 020fce40189548b49f6569aafb30beff14

Install 1 x part 3 Step 6 / 13

Install 2 x part 5 Step 7 / 13

Install 2 x part 3 Step 8 / 13

All installed parts have exactly the same dimension

## Assembly guide

12x

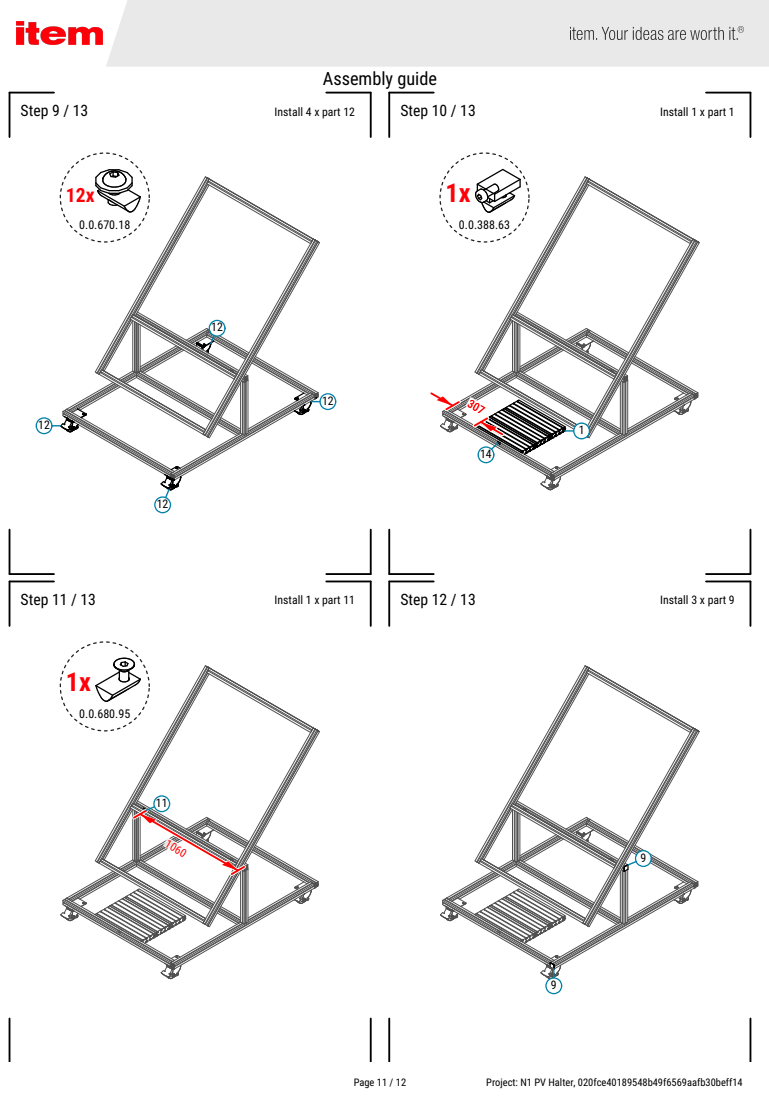
[picture p24: page 11]
Step 9 / 13; Install 4 x part 12; Step 10 / 13; Install 1 x part 1; Step 11 / 13; Install 1 x part 11; Step 12 / 13; Install 3 x part 9; Page 11 / 12; Project: N1 PV Halter, 020fce40189548b49f6569aafb30beff14

## Assembly guide

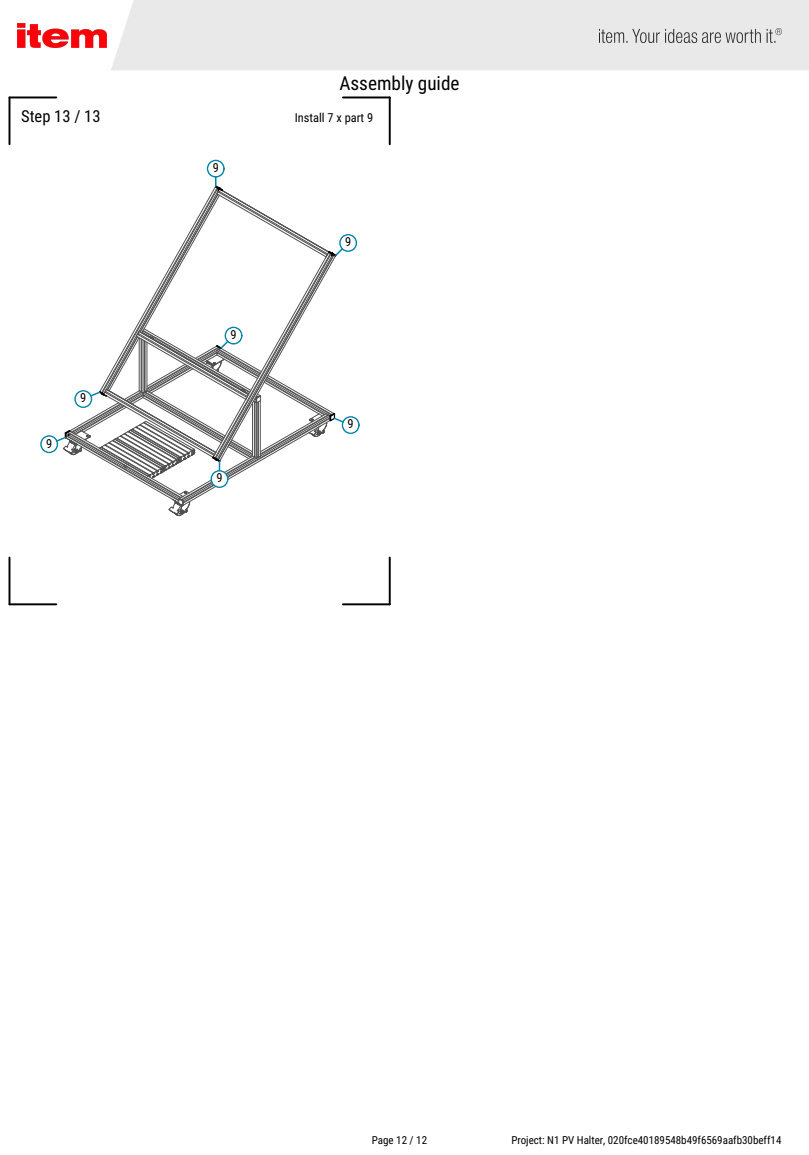
[picture p25: page 12]
Step 13 / 13; Install 7 x part 9; Page 12 / 12; Project: N1 PV Halter, 020fce40189548b49f6569aafb30beff14
