HTLD-2024-4cWI-SPL-G2-STH/2024-4cWI-SPL-G2-STH-TeamB/(commit log)

2025-04-29 Upload of the frame documentation
2025-06-09 Upload of the final frame documentation
2025-06-10 Final Design
    Uploaded file of the final frame design.
    [CAD_Design_Final.step]
